MechatronixLab/WPM/README.md

# WEARABLE PATIENT MONITOR  
  
This work is a proof of concept for a connected wearable patient monitor capable of measuring oximetry parameters, 
body temperature and track the patient's movement, while transmitting data wirelessly via LoRa communication.  
  
It is based on the [**Nucleo WL55JC1**](https://www.st.com/en/evaluation-tools/nucleo-wl55jc.html) development board, 
based on the [STM32WL55JC](https://www.st.com/en/microcontrollers-microprocessors/stm32wl55jc.html), from ST Microelectronics, 
a Maxim (now Analog Devices) [**MAX30102**](https://www.analog.com/en/products/max30102.html) pulse oximetry sensor, 
a Würth Elektronik [**WSEN-ISDS**](https://www.we-online.com/en/components/products/WSEN-ISDS) 6-Axis IMU, 
an **OLED display** and a **Piezoelectric buzzer** for simple audio generation.  
  
The device features LoRa connection, allowing it to be used in remote locations where telecommunications infrastructure is not well established.
  
## ⚠️ DISCLAIMER ⚠️  

**THIS IS NOT A MEDICAL DEVICE!**  
  
Putting a medical device on the market is no joke! It involves severe testing, documentation and certification.  
  
The device presented here is a benchtop prototype developed for learning purposes only. 
This prototype was not designed or tested for electrical safety and electromagnetic compatibility, nor went through clinical trials.  
  
**DO NOT TAKE MEDICAL DECISIONS BASED ON MEASUREMENTS TAKEN BY THIS DEVICE!**  
  
## VIDEO DEMONSTRATION

Video Demonstration (https://www.youtube.com/watch?v=pYWwEWDq1WM)  
  
## MOTIVATION

Many patients in need of medical assistance could be treated more comfortably at home, but monitoring their condition in a timely manner could be a challenge, especially if they live in rural areas.  
  
The goal of this project is to develop a low power, wirelessly connected, wearable device to monitor patient heart rate, oximetry, respiration rate, temperature and estimate overall condition. The device would include a microcontroller that manages sensors (such as optical, thermal, inertial, etc.) and connects to an IoT network such as LoRaWAN. A rechargeable battery would also be present, as well as the corresponding power management IC.  
  
The NUCLEO-WL55JC would be a great platform for prototyping such device, since it provides the sub-GHz radio and full access to the MCU pins. Sensors and other hardware parts can be integrated using I2C and SPI communication, and are generally available in breakout boards for easy development.  
  
This kind of device enables caregivers and physicians to monitor their patients remotely and gather information continuously. The data collected can also be processed autonomously using AI to detect potential degradation of patient’s condition and triggering alarms, while simpler analysis could be done directly by the IoT device (edge computing).  
  
The benefits of the device go beyond patient’s health. The overall treatment cost could be lowered since caregivers and physicians could focus attention on the most critical patients more often, and more stable patients can be visited more sporadically.  

This idea was submitted to the [STM32 Wireless Innovation Design Contest](https://www.elektormagazine.com/st-contest), promoted by [Elektor Magazine](https://www.elektormagazine.com/) and [ST Microelectronics](https://github.com/stmicroelectronics). They kindly provided a NUCLEO-WL55JC board, free of charge. Thank you!
  
## HARDWARE

### Hardware Block Diagram

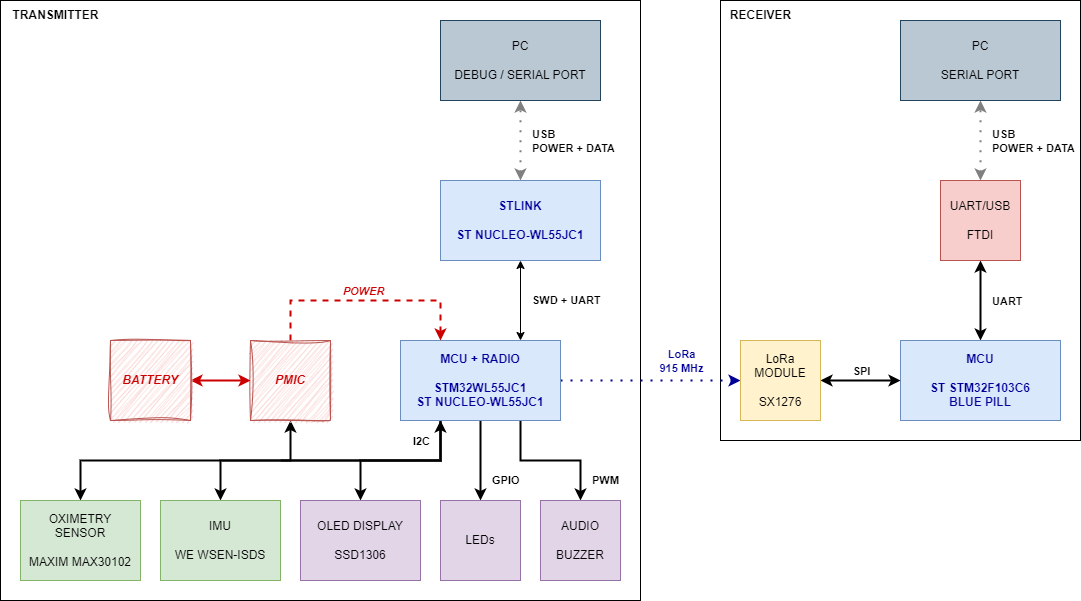
[picture p1: DOC/WPM-WL55_HARDWARE_BLOCK_DIAGRAM.png]
Hardware Block Diagram

  
### Benchtop Prototype  
  
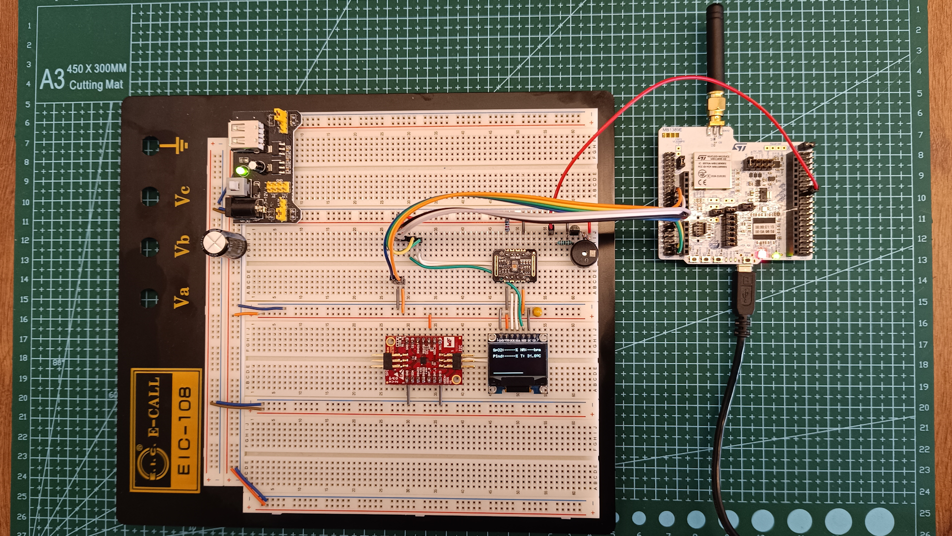
[picture p2: IMG/prototype.png]
Prototype


The image below highlights the main parts of the hardware (from right to left):  
- Nucleo board
- Piezoelectric buzzer
- MAX30102 breakout board
- OLED display (monochrome, 128 x 64 pixels)
- [WSEN-EVAL ISDS](https://www.we-online.com/en/components/products/WSEN-EVAL_ISDS) breakout board
- Voltage regulators (+5.0V and +3.3V)

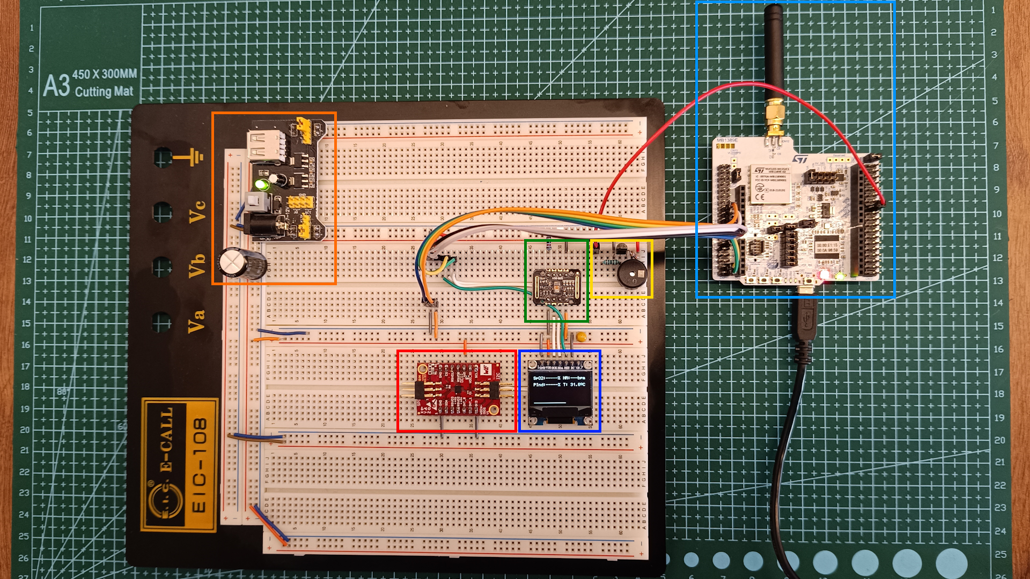
[picture p3: IMG/prototype_highlighted.png]
Prototype - Parts highlighted


The sensors and display are all controlled by the MCU via the same I2C bus. The buzzer is driven by a PWM signal with tone frequency of 4 kHz.
  
**Connections (CubeMX):**    
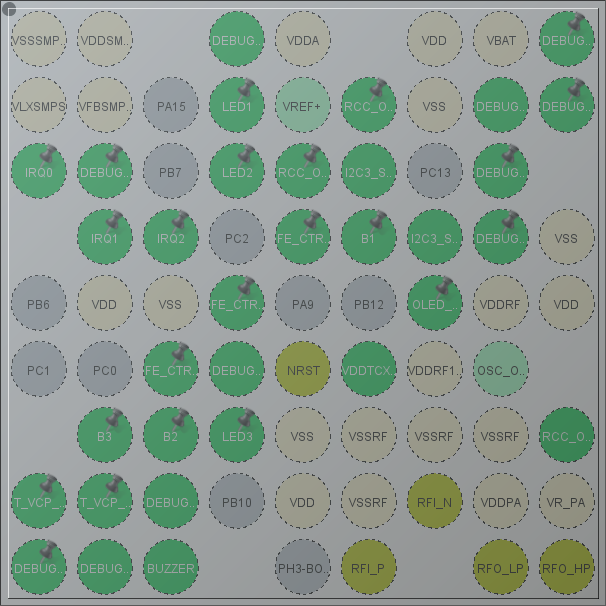
[picture p4: IMG/cubemx_pinout_detail.png]
Hardware connections


Pinout table for connection between the Nucleo board 
([Nucleo WL55JC1 schematic](https://www.st.com/resource/en/schematic_pack/mb1389-wl55jc-highband-e02_schematic.pdf)) 
and other components on the breadboard:

| **Nucleo WL55JC1** | **MCU Pin** | **Peripheral** | **Signal** |
|:---:|:---:|:---:|:---:|
| CN7 Pin 16 | VDD | - | +3.3V |
| CN7 Pin 18 | - | - | +5.0V |
| CN7 Pin 20 | VSS | - | GND |
| CN7 Pin 22 | VSS | - | GND |
| CN7 Pin 28 | PB1 | GPIO | OLED_RESET |
| CN7 Pin 36 | PB14 | I2C3 SDA | I2C SDA |
| CN7 Pin 38 | PB13 | I2C3 SCL | I2C SCL |
| CN10 Pin 16 | PA8 | TIM1 CH1 PWM Out | BUZZER |
  
### LoRa Receiver  
  
A very simple LoRa receiver was assembled using a [LoRa module](https://www.nicerf.com/lora-module/sx1276-lora-module-lora1276.html) from [G-NiceRF](https://www.nicerf.com/), 
which is based on the [SX1276](https://www.semtech.com/products/wireless-rf/lora-connect/sx1276) chip from [Semtech](https://www.semtech.com/), and a Blue Pill board, which is based on the ST Microelectronics [STM32F103C6](https://www.st.com/en/microcontrollers-microprocessors/stm32f103c6.html).    
The software running on the BluePill is a slightly modified version of [arduino-LoRa-STM32](https://github.com/armtronix/arduino-LoRa-STM32) that was developed by [ARMtronix Technologies](https://github.com/armtronix).
  
**LoRa module:**  
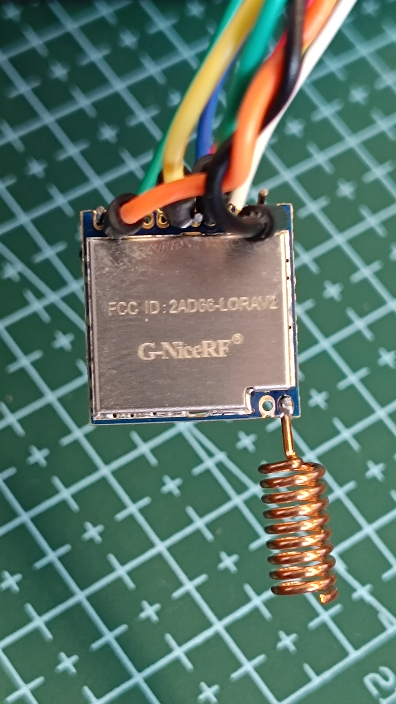
[picture p5: IMG/sx1276_module.png]

  
More information about how to make this receiver can be found on this [video](https://www.youtube.com/watch?v=A0RhP0SkhkQ&ab_channel=HowToElectronics) 
and [arcticle](https://how2electronics.com/interfacing-lora-sx1276-with-stm32-microcontroller-lr1276-915mhz/) from [How To Electronics](https://how2electronics.com/).
  
**Receiver:**    
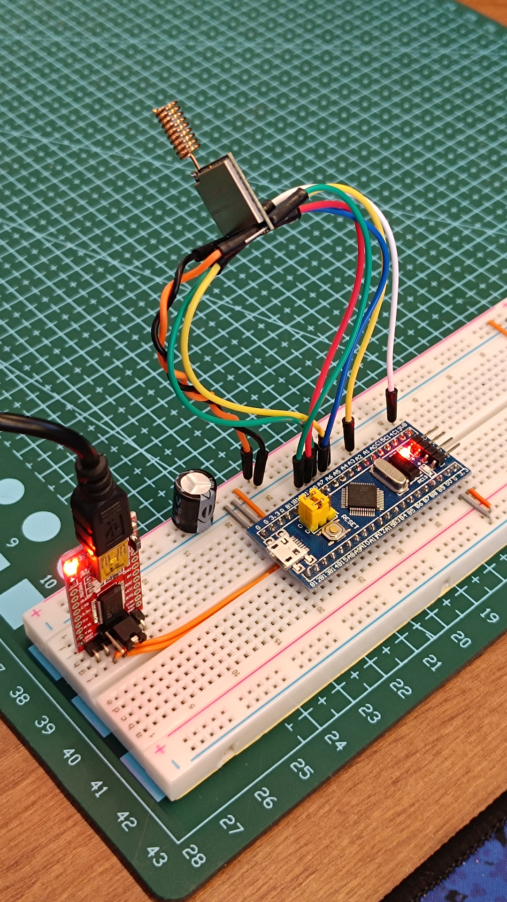
[picture p6: IMG/lora_receiver.png]

  
The software modifications made were necessary to match the radio configurations on the STM32WL55:  
- Frequency: 915 MHz  
- Bandwidth: 500 kHz  
- Spreading Factor: 11  
  
Pinout connections for LoRa receiver (white cable of previous image is not connected):  
  
| **BLUE PILL (STM32F103C6)** | **SX1276 MODULE** | **FTDI MODULE** |
|:---:|:---:|:---:|
| GND | GND | GND |
| +3.3V | VCC | VCC |
| PA4 | NSS | - |
| PA1 | DIO0 | - |
| PA5 | SCK | - |
| PA6 | MISO | - |
| PA7 | MOSI | - |
| PA9 | - | RX |
| PA10 | - | TX |
| PB0 | RST | - |
  
## SOFTWARE  

### Software Block Diagram

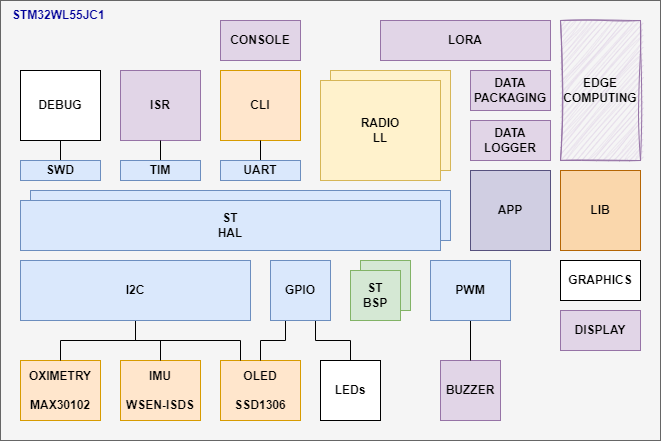
[picture p7: DOC/WPM-WL55_SOFTWARE_BLOCK_DIAGRAM.png]
Hardware Block Diagram

  
### Initialization
  
As the software starts, 3 opening screens are shown:  
  
**Project Title:**  
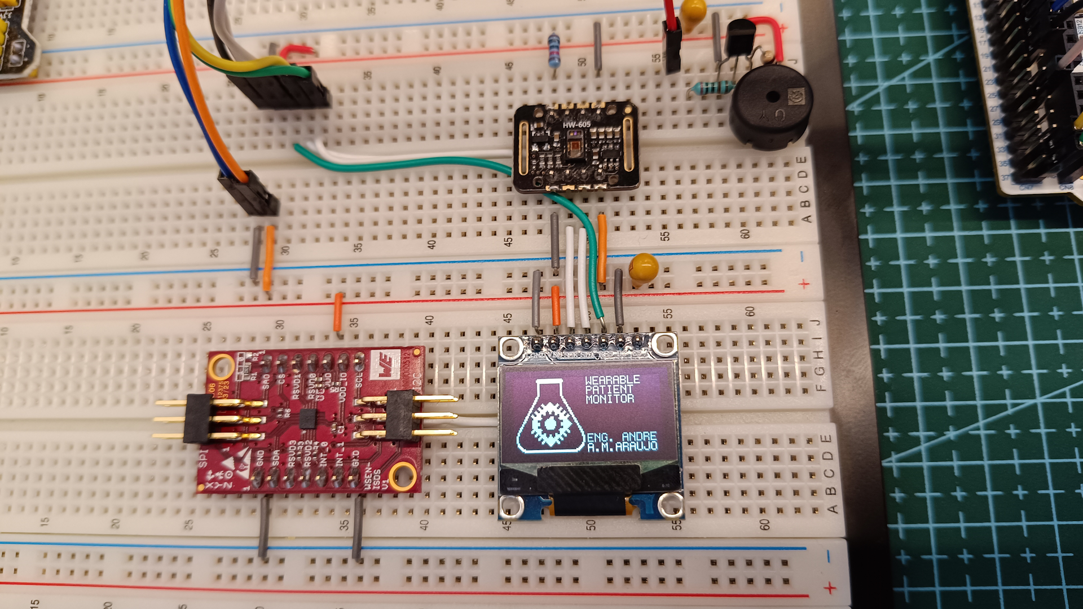
[picture p8: IMG/screen_opening_1.png]
Opening screen 1 - Project Title
  
  
**Software Version:**    
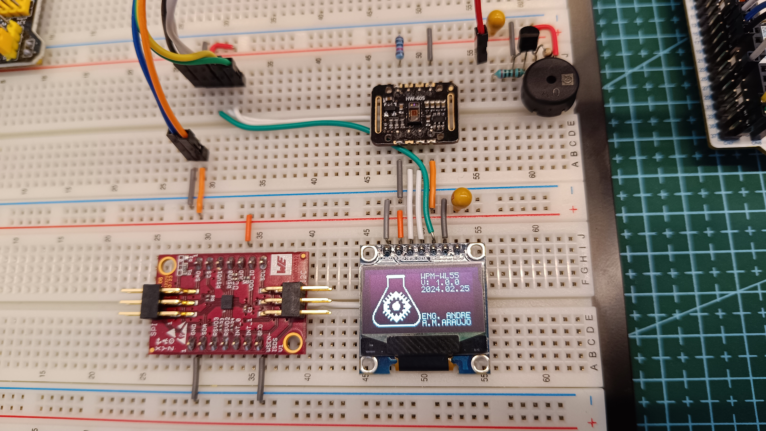
[picture p9: IMG/screen_opening_2.png]
Opening screen 2 - Software Version
  
  
**Elektor/ST Contest information:**  
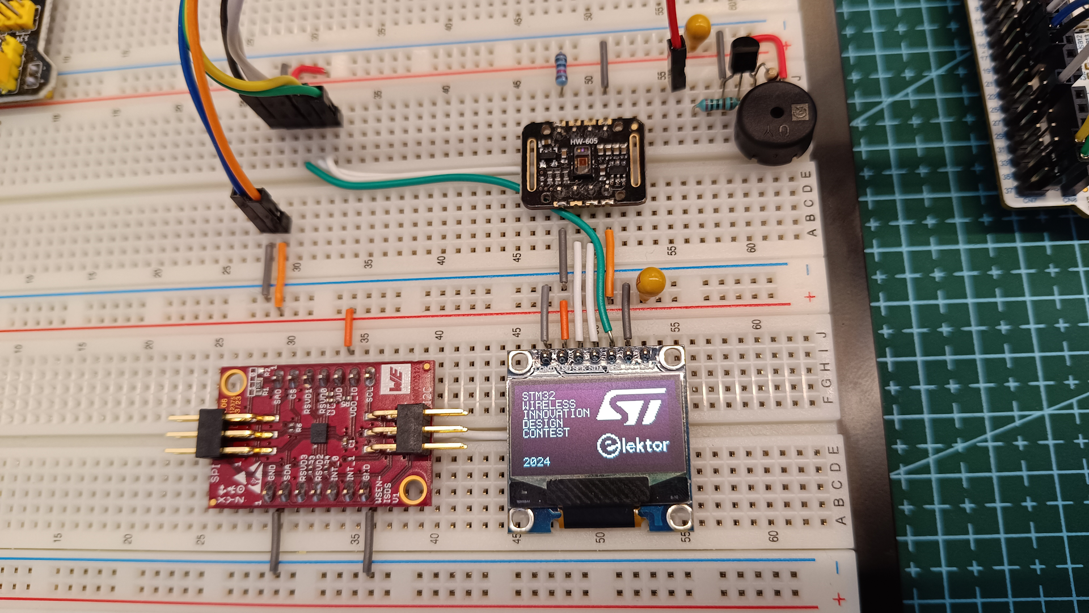
[picture p10: IMG/screen_opening_3.png]
Opening screen 3 - Elektor/ST Contest information
  
  
The device also prints data via its serial port. After initialization information, the device continuously transmits raw data from sensors at a rate of 30 Hz.
This transmission can only be done while the USB cable is connected to the Nucleo board, so it is available mainly for development and debugging purposes.  
  
Data is sent via LoRa at a rate of 1 Hz.    
  
**Console:**  
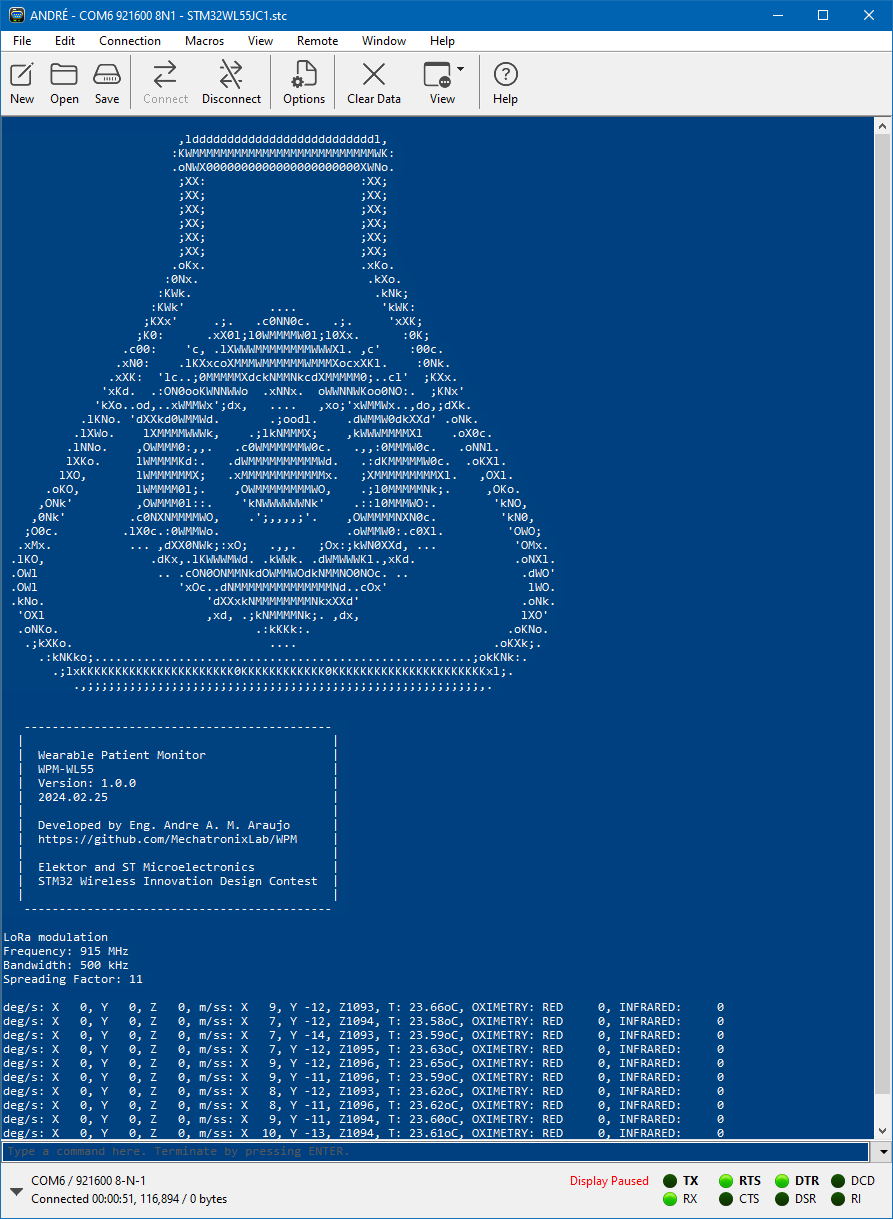
[picture p11: IMG/serial_console.png]
Serial console
    
  
### Measurements
  
The patient should place their finger over the MAX30102 sensor to get oximetry measurements.

The following parameters are present:
- **SpO2**: Peripheral Saturation of Oxygen (%)
- **PInd**: Perfusion Index (%)
- **HR**: Heart rate (beats per minute)
- **T**: Finger temperature (°C)
  
**Working oximetry measurements:**  
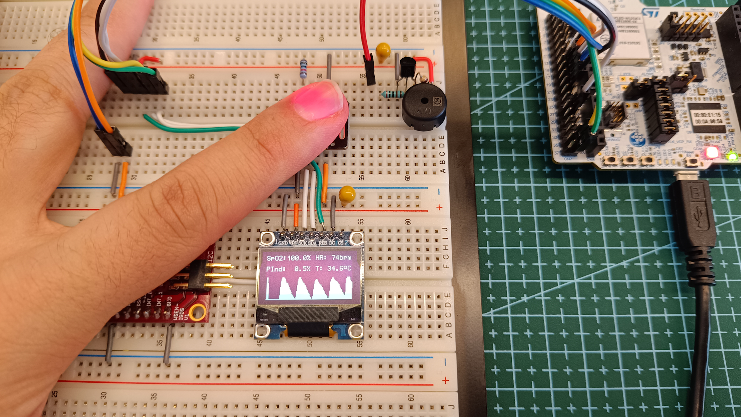
[picture p12: IMG/spo2_working.png]
Working oximetry measurements
  

Using the [Serial Oscilloscope](https://x-io.co.uk/serial-oscilloscope/) tool from [x-io Technologies](https://x-io.co.uk/), it is possible to plot the raw data transmitted from the prototype in real time:
  
**Gyroscope raw data:**  
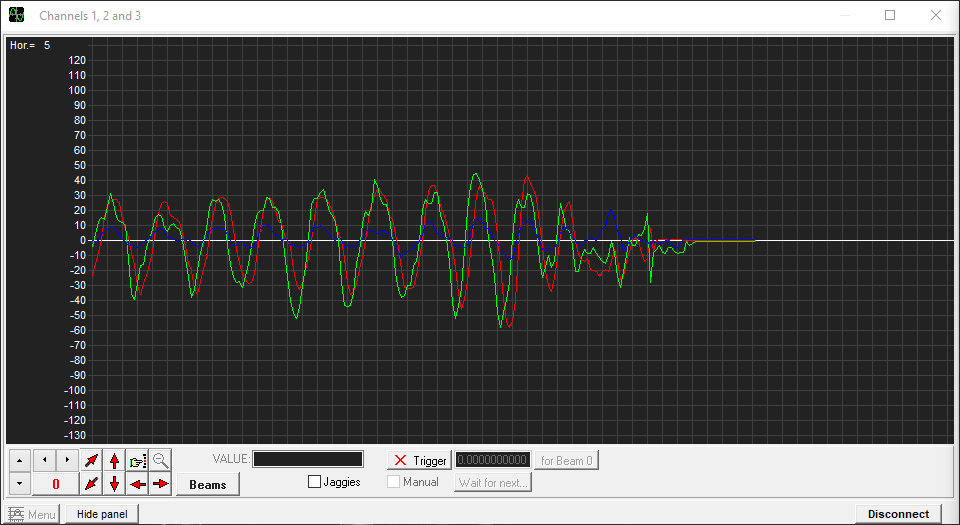
[picture p13: IMG/serial_oscilloscope_gyro.png]
Serial Oscilloscope - Gyroscope raw data
  
  
**Accelerometer raw data:**  
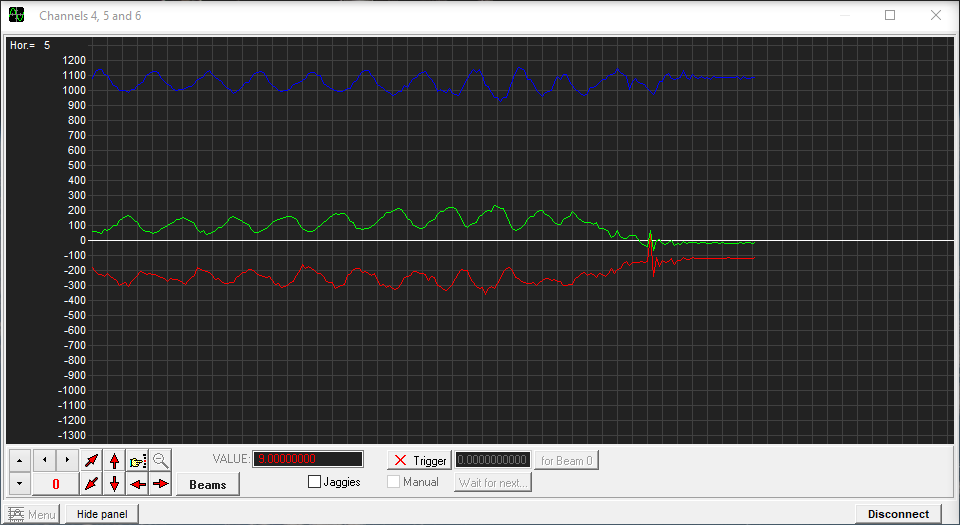
[picture p14: IMG/serial_oscilloscope_accel.png]
Serial Oscilloscope - Accelerometer raw data
  

**Oximetry raw data:**  
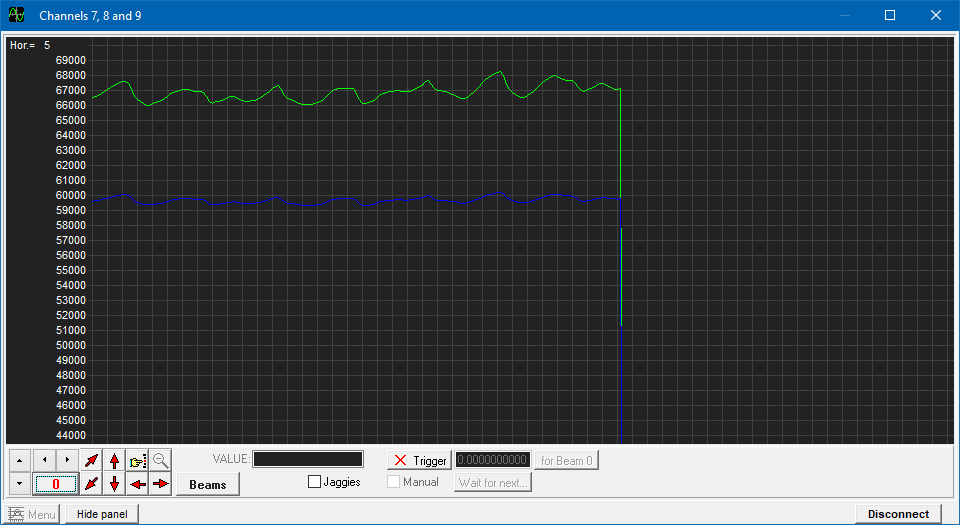
[picture p15: IMG/serial_oscilloscope_oxim.png]
Serial Oscilloscope - Oximetry raw data
  
  
### LoRa Receiver
  
The receiver simply relays data from the LoRa module to the UART, which is then converted to USB and captured by a computer.  
  
**Data received via LoRa:**  
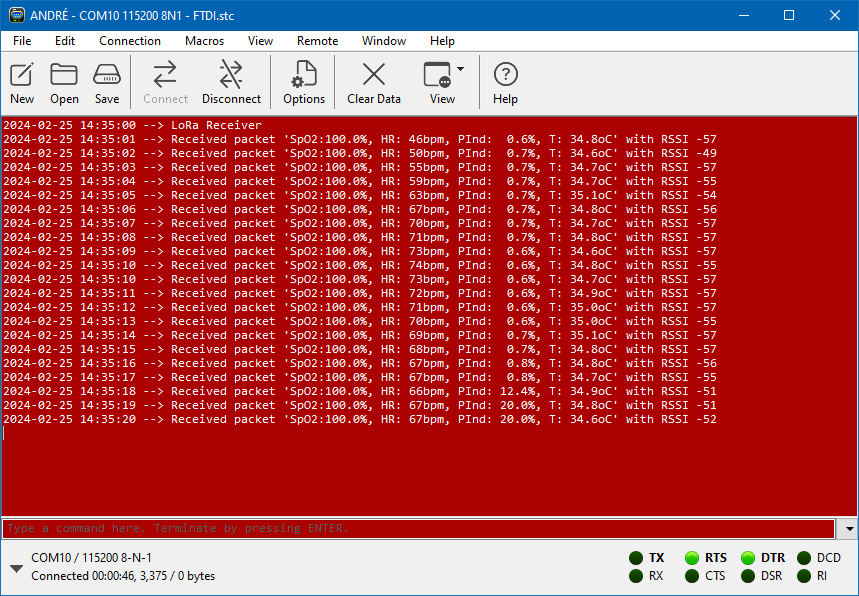
[picture p16: IMG/lora_receiver_serial.png]
Data received via LoRa
  

### Code organization
  
Code is organized according to the following layered architecture diagram.

**Layered architecture software diagram:**
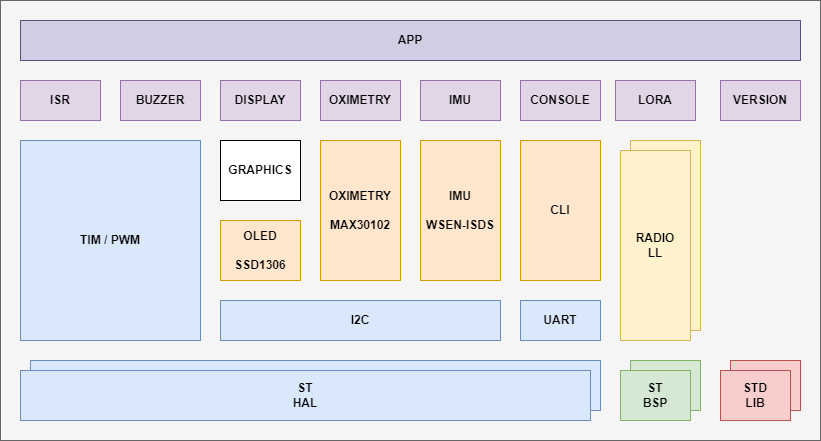
[picture p17: DOC/WPM-WL55_LAYERED_DIAGRAM.png]
  

The idea is that each block in the diagram corresponds to a pair of .c/.h files that are loosely coupled, so the interfaces of libraries occur only in the vertical direction, and only one layer at a time. 
However, since the code is still in development, there are a few exceptions to this guideline throughout the code. Data is manipulated between layers using structures and pointers.  

### Sub-GHz module
  
The most complex part of the project was to get the Sub-GHz module working correctly. 
Most of the examples available on the CubeMX package rely on a scheduler that uses function pointers and is not trivial to understand. 
Additionally, most examples demand two Nucleo boards, and this project had only one available. 
Therefore, a simpler approach was used by configuring the Sub-GHz module using the Low Lever drivers.
[This arcticle](https://forum.digikey.com/t/using-the-low-level-sub-ghz-radio-driver-for-the-stm32wl-series/18253) 
detais the procedure on how to set the radio correctly, and was used as base for starting software development. All other modules were added upon this foundation.  
  
## SIGNAL PROCESSING
  
One of the most interesting part of this project was dealing with the raw data coming from the red and infrared LEDs present on the oximetry sensor.  

In order to obtain the peripheral oxygen saturation value, the algorithm detailed on [this application note from Maxim](https://pdfserv.maximintegrated.com/en/an/AN6409.pdf).  
Another great resource about this topic is [this one from Texas Instruments](https://www.ti.com/lit/an/slaa655/slaa655.pdf).  

The basic idea is to get the DC and AC component from both red and infrared signals, then obtain the "Ratio of Ratios" and use it in a linear regression to finally get an approximate SpO2 value. 
This obviously leads to deviations from the real oxygen saturation of the patient, but this simplification is reasonable for this POC.  

**Raw signal with DC and AC components; Linear regression using the Ratio of Ratios:**
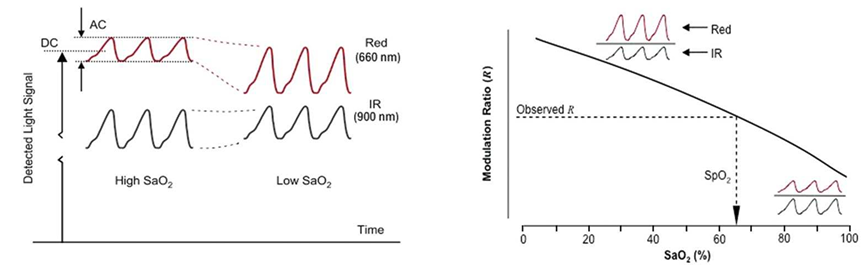
[picture p18: DOC/signal_processing.png]
  

A series of circular buffers were used to calculate the moving average of the two signals, to get DC values and the RMS calculation was used to obtain the AC values.

To get the heart rate, the derivative of the red signal in respect to time is used, and since the negative parts of the derivative are more abrupt, they were used to signal a heartbeat detection.
Again, circular buffer were used to get moving averages of beats for a number of samples, and then the heart rate in beats per minute is calculated.  
  
## PROTOTYPE PERFORMANCE
  
In order to evaluate the performance of the oximetry, 
measurements were taken by the WPM prototype and a commercially available pulse oximeter, simultaneously. 
Results showed good coherence between the two devices.
  
**Comparison between WPM and a commercial pulse oximeter:**  
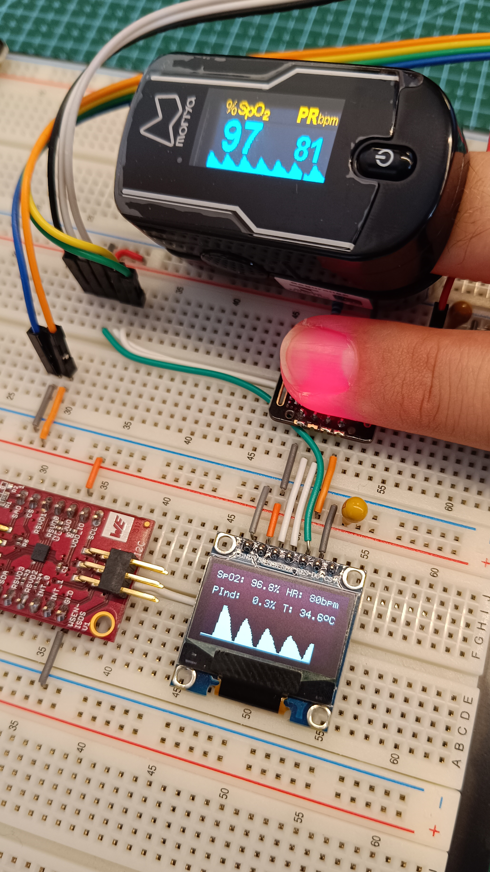
[picture p19: IMG/spo2_comparison.png]

  
## ACKNOWLEDGEMENTS    
  
My lovely wife and kids, for their everlasting support ❤️  
**Karine Moriya** and everyone @ [J.G. Moriya](https://jgmoriya.com.br/)  
[**Elecia White**](https://github.com/eleciawhite) and everyone @ [Classpert](https://lms.classpert.com/)  
[**Fabio Souza**](https://github.com/FBSeletronica) and [**Halysson Jr**](https://github.com/halyssonjr) @ [Franzininho](https://github.com/Franzininho)  
**William Maia** and **Daniel Botelho** @ [ST Microelectronics](https://github.com/stmicroelectronics) Brazil  
**Fabio Costa** and **Érico Hassegawa** @ [Würth Elektronik](https://github.com/WurthElektronik) Brazil  
**Maristone Gomes**, **Gabriel de Benevides** and **Fernando Júdice** @ [Salvus](https://www.salvus.me/)  
**Matt Mielke** @ DigiKey, for writing [this arcticle](https://forum.digikey.com/t/using-the-low-level-sub-ghz-radio-driver-for-the-stm32wl-series/18253) explaining how to use the Sub-GHz module on the STM32WL55  
[**Elektor Magazine**](https://www.elektormagazine.com/) and [**ST Microelectronics**](https://github.com/stmicroelectronics), for promoting the [STM32 Wireless Innovation Design Contest](https://www.elektormagazine.com/st-contest)
