MechatronixLab/WPM/DOC/ELEKTOR LABS PROJECT IMAGES/project_image_elektor_labs.jpg

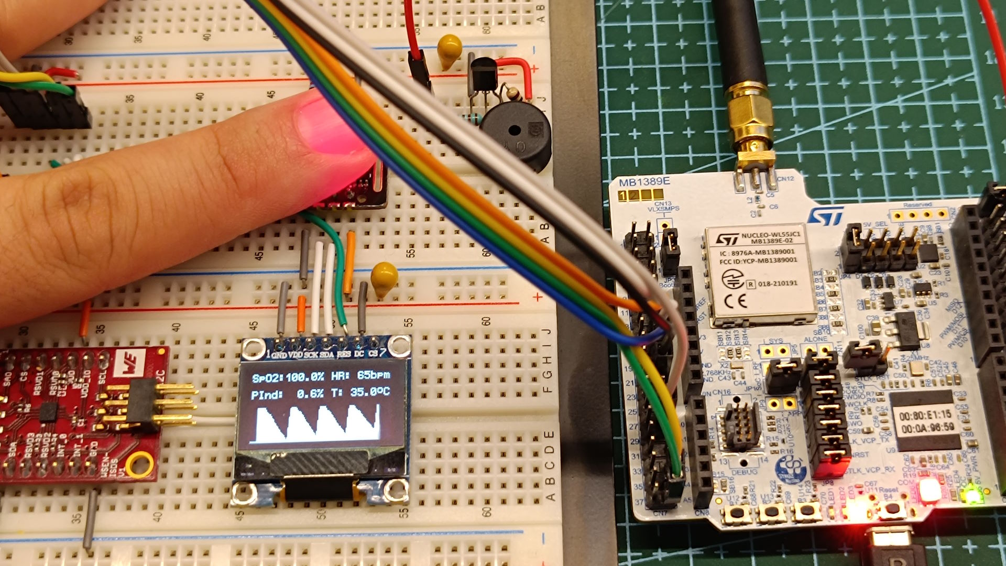
DOC/ELEKTOR LABS PROJECT IMAGES/project_image_elektor_labs.jpg
