MechatronixLab/WPM/IMG/cubemx_pinout.png

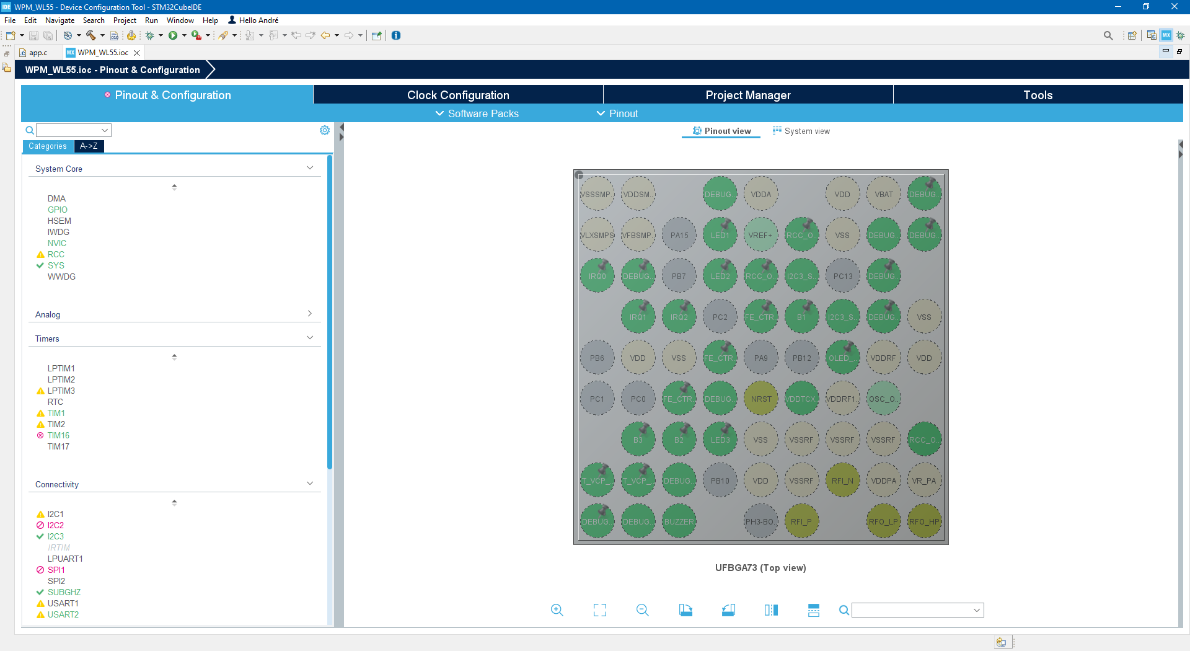
IMG/cubemx_pinout.png
