MechatronixLab/WPM/IMG/serial_oscilloscope.png

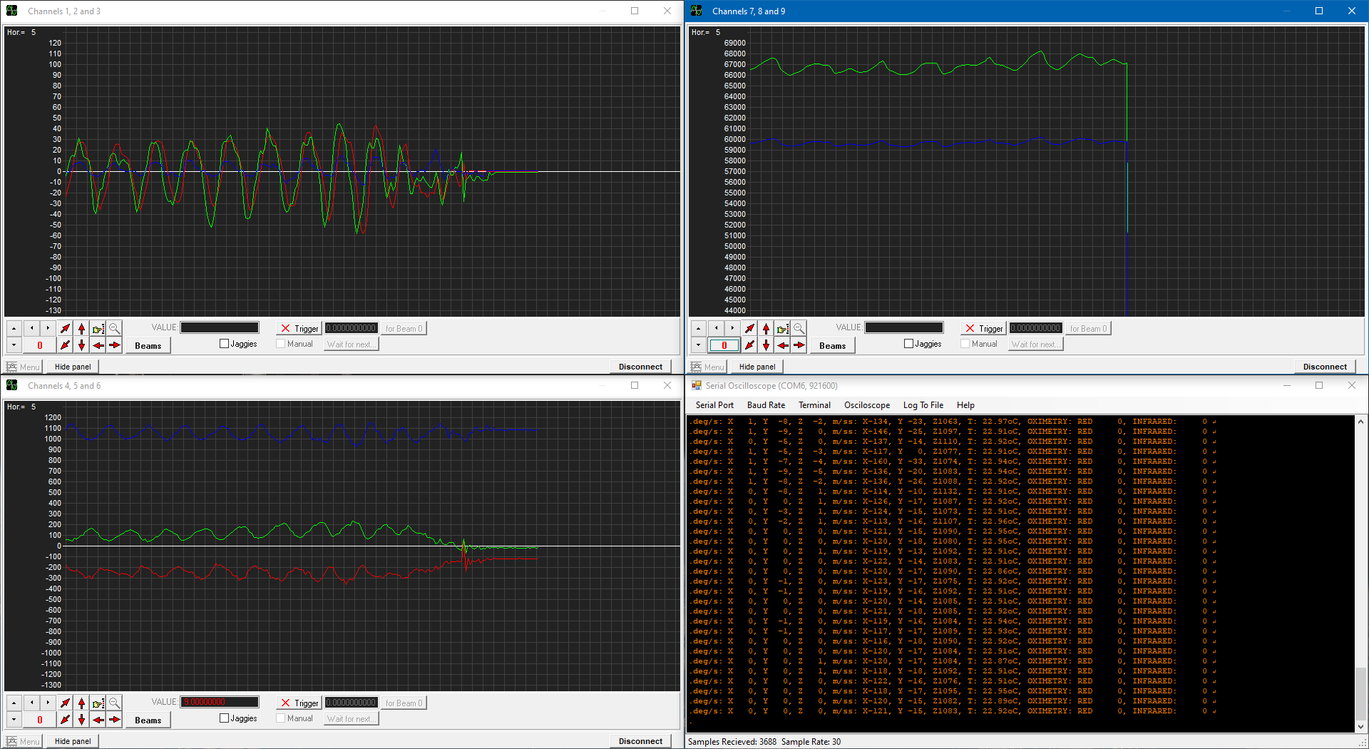
IMG/serial_oscilloscope.png
