MechatronixLab/WPM/IMG/serial_oscilloscope_raw.png

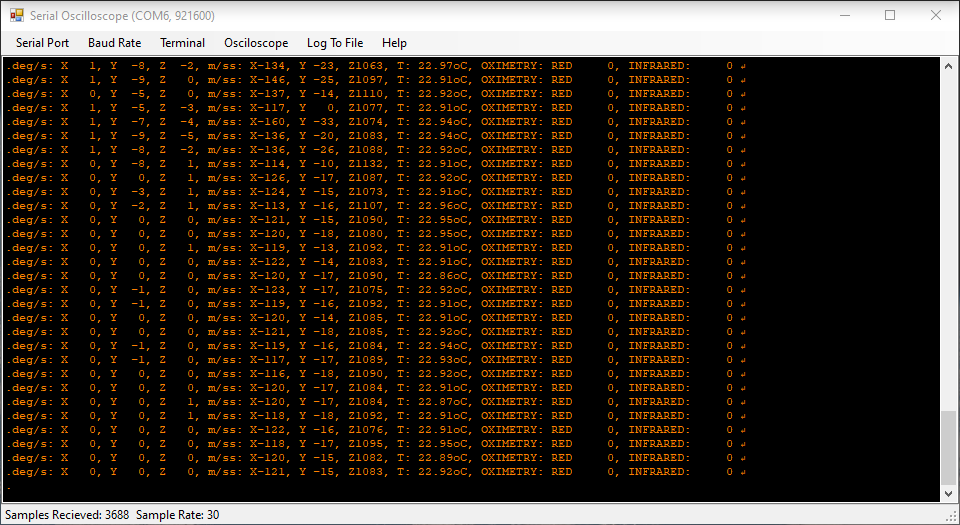
IMG/serial_oscilloscope_raw.png
