MechatronixLab/WPM/IMG/tim16_warning.png

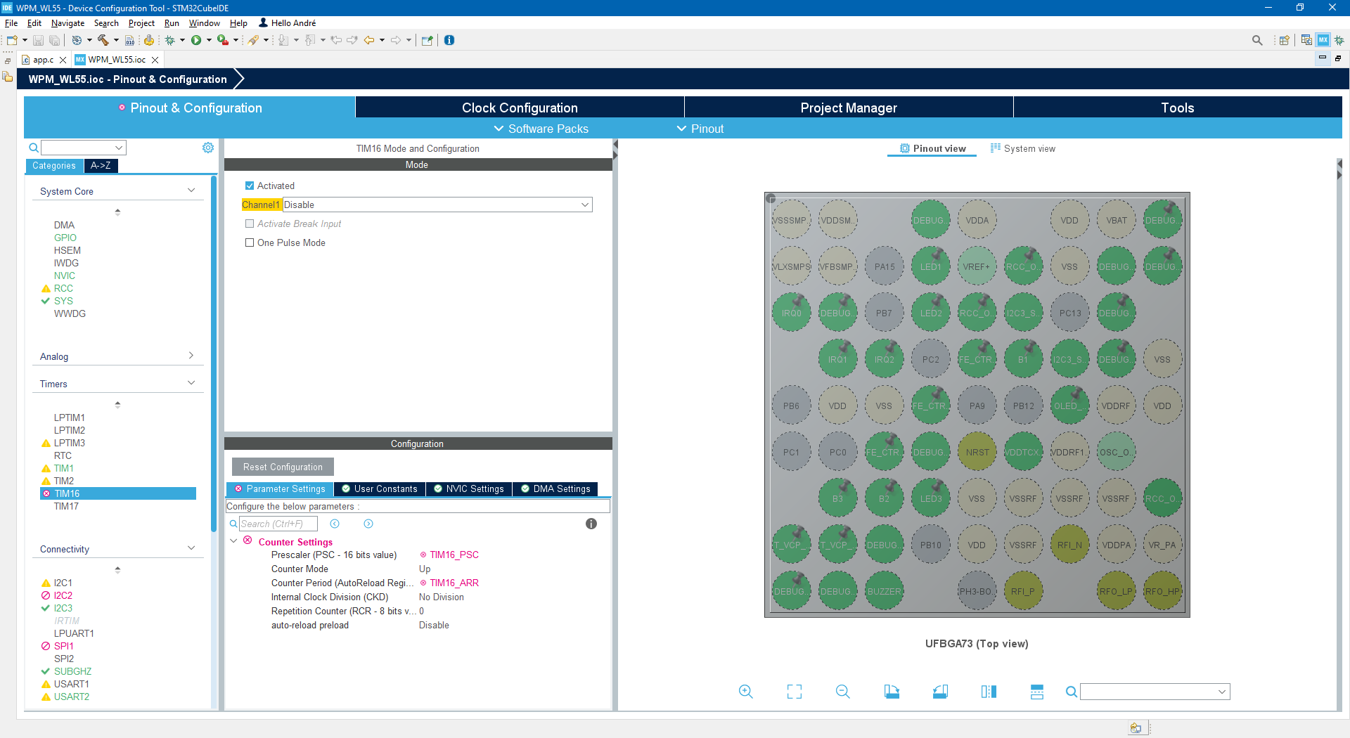
IMG/tim16_warning.png
