MechatronixLab/WPM/SOFTWARE/WPM_WL55/WPM_WL55/WPM_WL55.ioc

Mcu.UserName=STM32WL55JCIx
PA0.GPIO_Label=B1
PA0.Signal=GPXTI0
PA1.GPIO_Label=B2
PA1.Signal=GPXTI1
PA10.Signal=DEBUG_RF-HSE32RDY
PA11.Signal=DEBUG_RF-NRESET
PA12.Signal=DEBUG_RF-BUSY
PA13.Signal=DEBUG_JTMS-SWDIO
PA14.Signal=DEBUG_JTCK-SWCLK
PA2.GPIO_Label=T_VCP_RX
PA2.Signal=USART2_TX
PA3.GPIO_Label=T_VCP_RX
PA3.Signal=USART2_RX
PA4.Signal=DEBUG_SUBGHZSPI-NSSOUT
PA5.Signal=DEBUG_SUBGHZSPI-SCKOUT
PA6.Signal=DEBUG_SUBGHZSPI-MISOOUT
PA7.Signal=DEBUG_SUBGHZSPI-MOSIOUT
PA8.GPIO_Label=BUZZER
PA8.Signal=S_TIM1_CH1
PB0-VDD_TCXO.Signal=VDDTCXO
PB1.GPIO_Label=OLED_RESET
PB1.Signal=GPIO_Output
PB11.GPIO_Label=LED3
PB11.Signal=GPIO_Output
PB13.Signal=I2C3_SCL
PB14.Signal=I2C3_SDA
PB15.GPIO_Label=LED1
PB15.Signal=GPIO_Output
PB2.Signal=DEBUG_RF-SMPSRDY
PB3.GPIO_Label=IRQ0
PB3.Signal=EVENTOUT
PB4.Signal=DEBUG_RF-LDORDY
PB5.GPIO_Label=IRQ1
PB5.Signal=EVENTOUT
PB8.GPIO_Label=IRQ2
PB8.Signal=EVENTOUT
PB9.GPIO_Label=LED2
PB9.Signal=GPIO_Output
PC14-OSC32_IN.Signal=RCC_OSC32_IN
PC15-OSC32_OUT.Signal=RCC_OSC32_OUT
PC3.GPIO_Label=FE_CTRL3
PC3.Signal=GPIO_Output
PC4.GPIO_Label=FE_CTRL1
PC4.Signal=GPIO_Output
PC5.GPIO_Label=FE_CTRL2
PC5.Signal=GPIO_Output
PC6.GPIO_Label=B3
PC6.Signal=GPXTI6
