MechatronixLab/WPM/SOFTWARE/WPM_WL55/WPM_WL55/Core/Inc/main.h

#define LED1_Pin GPIO_PIN_15
#define LED1_GPIO_Port GPIOB
#define IRQ0_Pin GPIO_PIN_3
#define IRQ0_GPIO_Port GPIOB
#define LED2_Pin GPIO_PIN_9
#define LED2_GPIO_Port GPIOB
#define IRQ1_Pin GPIO_PIN_5
#define IRQ1_GPIO_Port GPIOB
#define IRQ2_Pin GPIO_PIN_8
#define IRQ2_GPIO_Port GPIOB
#define FE_CTRL3_Pin GPIO_PIN_3
#define FE_CTRL3_GPIO_Port GPIOC
#define B1_Pin GPIO_PIN_0
#define B1_GPIO_Port GPIOA
#define B1_EXTI_IRQn EXTI0_IRQn
#define FE_CTRL2_Pin GPIO_PIN_5
#define FE_CTRL2_GPIO_Port GPIOC
#define OLED_RESET_Pin GPIO_PIN_1
#define OLED_RESET_GPIO_Port GPIOB
#define FE_CTRL1_Pin GPIO_PIN_4
#define FE_CTRL1_GPIO_Port GPIOC
#define B3_Pin GPIO_PIN_6
#define B3_GPIO_Port GPIOC
#define B3_EXTI_IRQn EXTI9_5_IRQn
#define B2_Pin GPIO_PIN_1
#define B2_GPIO_Port GPIOA
#define B2_EXTI_IRQn EXTI1_IRQn
#define LED3_Pin GPIO_PIN_11
#define LED3_GPIO_Port GPIOB
#define T_VCP_RX_Pin GPIO_PIN_3
#define T_VCP_RX_GPIO_Port GPIOA
#define T_VCP_RXA2_Pin GPIO_PIN_2
#define T_VCP_RXA2_GPIO_Port GPIOA
#define BUZZER_Pin GPIO_PIN_8
#define BUZZER_GPIO_Port GPIOA
