MechatronixLab/WPM/SOFTWARE/WPM_WL55/WPM_WL55/App/Src/lora.c

/*
 * lora.c
 *
 *  Created on: Feb 1, 2024
 *      Author: Eng. André A. M. Araújo
 */

// References:
// https://forum.digikey.com/t/using-the-low-level-sub-ghz-radio-driver-for-the-stm32wl-series/18253
// https://github.com/eewiki/stm32wl_radioDriver_pingPong/tree/main

#include "lora.h"

void (*volatile eventReceptor)(pingPongFSM_t *const fsm);
PacketParams_t packetParams;  // TODO: this is lazy

static pingPongFSM_t fsm;
static char uartBuff[100];

const RadioLoRaBandwidths_t Bandwidths[] = { LORA_BW_125, LORA_BW_250, LORA_BW_500 };

/**
  * @brief  Initialize the Sub-GHz radio and dependent hardware.
  * @retval None
  */
void LORA_RadioInit(void)
{
	char string_buffer[64];

	CLI_Write("LoRa modulation \r\n");
	sprintf(string_buffer, "Frequency: %d MHz \r\n", LORA_RF_FREQUENCY/1000000);
	CLI_Write(string_buffer);
	sprintf(string_buffer, "Bandwidth: %d kHz \r\n", (1 << LORA_BANDWIDTH) * 125);
	CLI_Write(string_buffer);
	sprintf(string_buffer, "Spreading Factor: %d \r\n", LORA_SPREADING_FACTOR);
	CLI_Write(string_buffer);
	CLI_NewLine();

	// Initialize the hardware (SPI bus, TCXO control, RF switch)
	SUBGRF_Init(LORA_RadioIRQ);

	// Use DCDC converter if `DCDC_ENABLE` is defined in radio_conf.h
	// "By default, the SMPS clock detection is disabled and must be enabled before enabling the SMPS." (6.1 in RM0453)
	SUBGRF_WriteRegister(SUBGHZ_SMPSC0R, (SUBGRF_ReadRegister(SUBGHZ_SMPSC0R) | SMPS_CLK_DET_ENABLE));
	SUBGRF_SetRegulatorMode();

	// Use the whole 256-byte buffer for both TX and RX
	SUBGRF_SetBufferBaseAddress(0x00, 0x00);

	SUBGRF_SetRfFrequency(LORA_RF_FREQUENCY);
	SUBGRF_SetRfTxPower(LORA_TX_POWER);
	SUBGRF_SetStopRxTimerOnPreambleDetect(false);

	SUBGRF_SetPacketType(PACKET_TYPE_LORA);

	SUBGRF_WriteRegister( REG_LR_SYNCWORD, ( LORA_MAC_PRIVATE_SYNCWORD >> 8 ) & 0xFF );
	SUBGRF_WriteRegister( REG_LR_SYNCWORD + 1, LORA_MAC_PRIVATE_SYNCWORD & 0xFF );

	ModulationParams_t modulationParams;
	modulationParams.PacketType = PACKET_TYPE_LORA;
	modulationParams.Params.LoRa.Bandwidth = Bandwidths[LORA_BANDWIDTH];
	modulationParams.Params.LoRa.CodingRate = (RadioLoRaCodingRates_t)LORA_CODINGRATE;
	modulationParams.Params.LoRa.LowDatarateOptimize = 0x00;
	modulationParams.Params.LoRa.SpreadingFactor = (RadioLoRaSpreadingFactors_t)LORA_SPREADING_FACTOR;
	SUBGRF_SetModulationParams(&modulationParams);

	packetParams.PacketType = PACKET_TYPE_LORA;
	packetParams.Params.LoRa.CrcMode = LORA_CRC_ON;
	packetParams.Params.LoRa.HeaderType = LORA_PACKET_VARIABLE_LENGTH;
	packetParams.Params.LoRa.InvertIQ = LORA_IQ_NORMAL;
	packetParams.Params.LoRa.PayloadLength = 0xFF;
	packetParams.Params.LoRa.PreambleLength = LORA_PREAMBLE_LENGTH;
	SUBGRF_SetPacketParams(&packetParams);

	//SUBGRF_SetLoRaSymbNumTimeout(LORA_SYMBOL_TIMEOUT);

	// WORKAROUND - Optimizing the Inverted IQ Operation, see DS_SX1261-2_V1.2 datasheet chapter 15.4
	// RegIqPolaritySetup @address 0x0736
	SUBGRF_WriteRegister( 0x0736, SUBGRF_ReadRegister( 0x0736 ) | ( 1 << 2 ) );

	LORA_Tx("Wearable Patient Monitor");
	HAL_Delay(300);
	LORA_Tx("WPM-WL55");
	HAL_Delay(300);
	LORA_Tx("Developed by Eng. Andre A. M. Araujo");
	HAL_Delay(300);
}


/**
  * @brief  Receive data trough SUBGHZSPI peripheral
  * @param  radioIrq  interrupt pending status information
  * @retval None
  */
void LORA_RadioIRQ(RadioIrqMasks_t radioIrq)
{
  switch (radioIrq)
  {
    case IRQ_TX_DONE:
      eventReceptor = eventTxDone;
      break;
    case IRQ_RX_DONE:
      eventReceptor = eventRxDone;
      break;
    case IRQ_RX_TX_TIMEOUT:
      if (SUBGRF_GetOperatingMode() == MODE_TX)
      {
        eventReceptor = eventTxTimeout;
      }
      else if (SUBGRF_GetOperatingMode() == MODE_RX)
      {
        eventReceptor = eventRxTimeout;
      }
      break;
    case IRQ_CRC_ERROR:
      eventReceptor = eventRxError;
      break;
    default:
      break;
  }
}


/**
  * @brief  Process the TX Done event
  * @param  fsm pointer to FSM context
  * @retval None
  */
void eventTxDone(pingPongFSM_t *const fsm)
{
  HAL_UART_Transmit(&huart2, (uint8_t *)"Event TX Done\r\n", 15, HAL_MAX_DELAY);
  switch (fsm->state)
  {
    case STATE_MASTER:
      switch (fsm->subState)
      {
        case SSTATE_TX:
          enterMasterRx(fsm);
          fsm->subState = SSTATE_RX;
          break;
        default:
          break;
      }
      break;
    case STATE_SLAVE:
      switch (fsm->subState)
      {
        case SSTATE_TX:
          enterSlaveRx(fsm);
          fsm->subState = SSTATE_RX;
          break;
        default:
          break;
      }
      break;
    default:
      break;
  }
}


/**
  * @brief  Process the RX Done event
  * @param  fsm pointer to FSM context
  * @retval None
  */
void eventRxDone(pingPongFSM_t *const fsm)
{
  HAL_UART_Transmit(&huart2, (uint8_t *)"Event RX Done\r\n", 15, HAL_MAX_DELAY);
  HAL_UART_Transmit(&huart2, (uint8_t *)"RX Buffer: ", 11, HAL_MAX_DELAY);
  HAL_UART_Transmit(&huart2, (uint8_t *)fsm->rxBuffer, strlen((char *)fsm->rxBuffer), HAL_MAX_DELAY);
  HAL_UART_Transmit(&huart2, (uint8_t *)"\r\n", 2, HAL_MAX_DELAY);
  switch(fsm->state)
  {
    case STATE_MASTER:
      switch (fsm->subState)
      {
        case SSTATE_RX:
          transitionRxDone(fsm);
          if (strncmp(fsm->rxBuffer, "PONG", 4) == 0)
          {
            BSP_LED_Off(LED_GREEN);
            BSP_LED_Toggle(LED_RED);
            enterMasterTx(fsm);
            fsm->subState = SSTATE_TX;
          }
          else if (strncmp(fsm->rxBuffer, "PING", 4) == 0)
          {
            enterSlaveRx(fsm);
            fsm->state = STATE_SLAVE;
          }
          else
          {
        	  enterMasterRx(fsm);
          }
          break;
        default:
          break;
      }
      break;
    case STATE_SLAVE:
      switch (fsm->subState)
      {
        case SSTATE_RX:
          transitionRxDone(fsm);
          if (strncmp(fsm->rxBuffer, "PING", 4) == 0)
          {
            BSP_LED_Off(LED_RED);
            BSP_LED_Toggle(LED_GREEN);
            enterSlaveTx(fsm);
            fsm->subState = SSTATE_TX;
          }
          else
          {
            enterMasterRx(fsm);
            fsm->state = STATE_MASTER;
          }
          break;
        default:
          break;
      }
      break;
    default:
      break;
  }
}


/**
  * @brief  Process the TX Timeout event
  * @param  fsm pointer to FSM context
  * @retval None
  */
void eventTxTimeout(pingPongFSM_t *const fsm)
{
  HAL_UART_Transmit(&huart2, (uint8_t *)"Event TX Timeout\r\n", 18, HAL_MAX_DELAY);
  switch (fsm->state)
  {
    case STATE_MASTER:
      switch (fsm->subState)
      {
        case SSTATE_TX:
          enterMasterRx(fsm);
          fsm->subState = SSTATE_RX;
          break;
        default:
          break;
      }
      break;
    case STATE_SLAVE:
      switch (fsm->subState)
      {
        case SSTATE_TX:
          enterSlaveRx(fsm);
          fsm->subState = SSTATE_RX;
          break;
        default:
          break;
      }
      break;
    default:
      break;
  }
}


/**
  * @brief  Process the RX Timeout event
  * @param  fsm pointer to FSM context
  * @retval None
  */
void eventRxTimeout(pingPongFSM_t *const fsm)
{
  HAL_UART_Transmit(&huart2, (uint8_t *)"Event RX Timeout\r\n", 18, HAL_MAX_DELAY);

  BSP_LED_On(LED_RED);
  HAL_Delay(10);
  BSP_LED_Off(LED_RED);


  switch (fsm->state)
  {
    case STATE_MASTER:
      switch (fsm->subState)
      {
        case SSTATE_RX:
          HAL_Delay(fsm->randomDelay);
          enterMasterTx(fsm);
          fsm->subState = SSTATE_TX;
          break;
        default:
          break;
      }
      break;
    case STATE_SLAVE:
      switch (fsm->subState)
      {
        case SSTATE_RX:
          enterSlaveRx(fsm);
          break;
        default:
          break;
      }
      break;
    default:
      break;
  }
}


/**
  * @brief  Process the RX Error event
  * @param  fsm pointer to FSM context
  * @retval None
  */
void eventRxError(pingPongFSM_t *const fsm)
{
  HAL_UART_Transmit(&huart2, (uint8_t *)"Event Rx Error\r\n", 16, HAL_MAX_DELAY);
  switch (fsm->state)
  {
    case STATE_MASTER:
      switch (fsm->subState)
      {
        case SSTATE_RX:
          HAL_Delay(fsm->randomDelay);
          enterMasterTx(fsm);
          fsm->subState = SSTATE_TX;
          break;
        default:
          break;
      }
      break;
    case STATE_SLAVE:
      switch (fsm->subState)
      {
        case SSTATE_RX:
          enterSlaveRx(fsm);
          break;
        default:
          break;
      }
      break;
    default:
      break;
  }
}


/**
  * @brief  Entry actions for the RX sub-state of the Master state
  * @param  fsm pointer to FSM context
  * @retval None
  */
void enterMasterRx(pingPongFSM_t *const fsm)
{
  HAL_UART_Transmit(&huart2, (uint8_t *)"Master Rx start\r\n", 17, HAL_MAX_DELAY);
  SUBGRF_SetDioIrqParams( IRQ_RX_DONE | IRQ_RX_TX_TIMEOUT | IRQ_CRC_ERROR | IRQ_HEADER_ERROR,
                          IRQ_RX_DONE | IRQ_RX_TX_TIMEOUT | IRQ_CRC_ERROR | IRQ_HEADER_ERROR,
                          IRQ_RADIO_NONE,
                          IRQ_RADIO_NONE );
  SUBGRF_SetSwitch(RFO_LP, RFSWITCH_RX);
  packetParams.Params.LoRa.PayloadLength = 0xFF;
  SUBGRF_SetPacketParams(&packetParams);
  SUBGRF_SetRx(fsm->rxTimeout << 6);
}


/**
  * @brief  Entry actions for the RX sub-state of the Slave state
  * @param  fsm pointer to FSM context
  * @retval None
  */
void enterSlaveRx(pingPongFSM_t *const fsm)
{
  HAL_UART_Transmit(&huart2, (uint8_t *)"Slave Rx start\r\n", 16, HAL_MAX_DELAY);
  SUBGRF_SetDioIrqParams( IRQ_RX_DONE | IRQ_RX_TX_TIMEOUT | IRQ_CRC_ERROR | IRQ_HEADER_ERROR,
                          IRQ_RX_DONE | IRQ_RX_TX_TIMEOUT | IRQ_CRC_ERROR | IRQ_HEADER_ERROR,
                          IRQ_RADIO_NONE,
                          IRQ_RADIO_NONE );
  SUBGRF_SetSwitch(RFO_LP, RFSWITCH_RX);
  packetParams.Params.LoRa.PayloadLength = 0xFF;
  SUBGRF_SetPacketParams(&packetParams);
  SUBGRF_SetRx(fsm->rxTimeout << 6);
}


/**
  * @brief  Entry actions for the TX sub-state of the Master state
  * @param  fsm pointer to FSM context
  * @retval None
  */
void enterMasterTx(pingPongFSM_t *const fsm)
{
  HAL_Delay(fsm->rxMargin);

  HAL_UART_Transmit(&huart2, (uint8_t *)"...PING\r\n", 9, HAL_MAX_DELAY);
  HAL_UART_Transmit(&huart2, (uint8_t *)"Master Tx start\r\n", 17, HAL_MAX_DELAY);
  SUBGRF_SetDioIrqParams( IRQ_TX_DONE | IRQ_RX_TX_TIMEOUT,
                          IRQ_TX_DONE | IRQ_RX_TX_TIMEOUT,
                          IRQ_RADIO_NONE,
                          IRQ_RADIO_NONE );
  SUBGRF_SetSwitch(RFO_LP, RFSWITCH_TX);
  // Workaround 5.1 in DS.SX1261-2.W.APP (before each packet transmission)
  SUBGRF_WriteRegister(0x0889, (SUBGRF_ReadRegister(0x0889) | 0x04));
  packetParams.Params.LoRa.PayloadLength = 0x4;
  SUBGRF_SetPacketParams(&packetParams);
  SUBGRF_SendPayload((uint8_t *)"PING", 4, 0);
}


/**
  * @brief  Entry actions for the TX sub-state of the Slave state
  * @param  fsm pointer to FSM context
  * @retval None
  */
void enterSlaveTx(pingPongFSM_t *const fsm)
{
  HAL_Delay(fsm->rxMargin);

  HAL_UART_Transmit(&huart2, (uint8_t *)"...PONG\r\n", 9, HAL_MAX_DELAY);
  HAL_UART_Transmit(&huart2, (uint8_t *)"Slave Tx start\r\n", 16, HAL_MAX_DELAY);
  SUBGRF_SetDioIrqParams( IRQ_TX_DONE | IRQ_RX_TX_TIMEOUT,
                          IRQ_TX_DONE | IRQ_RX_TX_TIMEOUT,
                          IRQ_RADIO_NONE,
                          IRQ_RADIO_NONE );
  SUBGRF_SetSwitch(RFO_LP, RFSWITCH_TX);
  // Workaround 5.1 in DS.SX1261-2.W.APP (before each packet transmission)
  SUBGRF_WriteRegister(0x0889, (SUBGRF_ReadRegister(0x0889) | 0x04));
  packetParams.Params.LoRa.PayloadLength = 0x4;
  SUBGRF_SetPacketParams(&packetParams);
  SUBGRF_SendPayload((uint8_t *)"PONG", 4, 0);
}


/**
  * @brief  Transition actions executed on every RX Done event (helper function)
  * @param  fsm pointer to FSM context
  * @retval None
  */
void transitionRxDone(pingPongFSM_t *const fsm)
{
  PacketStatus_t packetStatus;
  char uartBuff[50];

  // Workaround 15.3 in DS.SX1261-2.W.APP (because following RX w/ timeout sequence)
  SUBGRF_WriteRegister(0x0920, 0x00);
  SUBGRF_WriteRegister(0x0944, (SUBGRF_ReadRegister(0x0944) | 0x02));

  SUBGRF_GetPayload((uint8_t *)fsm->rxBuffer, &fsm->rxSize, 0xFF);
  SUBGRF_GetPacketStatus(&packetStatus);

  sprintf(uartBuff, "RssiValue=%d dBm, SnrValue=%d Hz\r\n", packetStatus.Params.LoRa.RssiPkt, packetStatus.Params.LoRa.SnrPkt);
  HAL_UART_Transmit(&huart2, (uint8_t *)uartBuff, strlen(uartBuff), HAL_MAX_DELAY);
}

void LORA_FSM_Init(void)
{
	// get random number
	uint32_t rnd = 0;
	SUBGRF_SetDioIrqParams(IRQ_RADIO_NONE, IRQ_RADIO_NONE, IRQ_RADIO_NONE, IRQ_RADIO_NONE);
	rnd = SUBGRF_GetRandom();

	fsm.state = STATE_NULL;
	fsm.subState = SSTATE_NULL;
	fsm.rxTimeout = 3000; // 3000 ms
	fsm.rxMargin = 200;   // 200 ms
	fsm.randomDelay = rnd >> 22; // [0, 1023] ms
	sprintf(uartBuff, "rand=%lu\r\n", fsm.randomDelay);
	HAL_UART_Transmit(&huart2, (uint8_t *)uartBuff, strlen(uartBuff), HAL_MAX_DELAY);

	HAL_Delay(fsm.randomDelay);
	SUBGRF_SetDioIrqParams( IRQ_RX_DONE | IRQ_RX_TX_TIMEOUT | IRQ_CRC_ERROR,
						  IRQ_RX_DONE | IRQ_RX_TX_TIMEOUT | IRQ_CRC_ERROR,
						  IRQ_RADIO_NONE,
						  IRQ_RADIO_NONE );
	SUBGRF_SetSwitch(RFO_LP, RFSWITCH_RX);
	SUBGRF_SetRx(fsm.rxTimeout << 6);
	fsm.state = STATE_MASTER;
	fsm.subState = SSTATE_RX;

	LORA_Tx("LoRa config complete!");	// TODO: Works but breaks state machine
}

void LORA_Process(void)
{
	if (eventReceptor != NULL)
	{
		BSP_LED_On(LED_GREEN);

		eventReceptor(&fsm);
		eventReceptor = NULL;

		BSP_LED_Off(LED_GREEN);
	}
}

void LORA_Tx(char * lora_tx_buffer)
{
//	HAL_Delay(fsm->rxMargin);
//	HAL_UART_Transmit(&huart2, (uint8_t *)"...PING\r\n", 9, HAL_MAX_DELAY);
//	HAL_UART_Transmit(&huart2, (uint8_t *)"Master Tx start\r\n", 17, HAL_MAX_DELAY);

//	CLI_Write("Starting LoRa transmission... \r\n");
	SUBGRF_SetDioIrqParams( IRQ_TX_DONE | IRQ_RX_TX_TIMEOUT,
						  IRQ_TX_DONE | IRQ_RX_TX_TIMEOUT,
						  IRQ_RADIO_NONE,
						  IRQ_RADIO_NONE );
	SUBGRF_SetSwitch(RFO_LP, RFSWITCH_TX);
	// Workaround 5.1 in DS.SX1261-2.W.APP (before each packet transmission)
	SUBGRF_WriteRegister(0x0889, (SUBGRF_ReadRegister(0x0889) | 0x04));
	packetParams.Params.LoRa.PayloadLength = strlen(lora_tx_buffer);
	SUBGRF_SetPacketParams(&packetParams);
	SUBGRF_SendPayload((uint8_t *)lora_tx_buffer, packetParams.Params.LoRa.PayloadLength, 0);
//	CLI_Write("LoRa packet transmitted \r\n");
}
