MechatronixLab/WPM/SOFTWARE/WPM_WL55/WPM_WL55/App/Src/wsen-isds.c

/*
 * wsen-isds.c
 *
 *  Created on: Nov 24, 2023
 *      Author: Eng. André A. M. Araújo
 */

#include "wsen-isds.h"

void	ISDS_Read	(uint8_t register_address, uint8_t data_size, uint8_t * I2C_buffer)
{
	I2C_buffer[0] = register_address;

	HAL_I2C_Master_Transmit(&ISDS_I2C_HANDLE, ISDS_DEVICE_ADDRESS, I2C_buffer,         1, ISDS_I2C_TIMEOUT);
	HAL_I2C_Master_Receive (&ISDS_I2C_HANDLE, ISDS_DEVICE_ADDRESS, I2C_buffer, data_size, ISDS_I2C_TIMEOUT);
}

void	ISDS_Write	(uint8_t register_address, uint8_t data)
{
	uint8_t I2C_buffer[2];

	I2C_buffer[0] = register_address;
	I2C_buffer[1] = data;

	HAL_I2C_Master_Transmit(&ISDS_I2C_HANDLE, ISDS_DEVICE_ADDRESS, I2C_buffer,         2, ISDS_I2C_TIMEOUT);
}

uint8_t ISDS_CommunicationCheck(void)
{
	uint8_t I2C_buffer[1];
	uint8_t status = 0;

	ISDS_Read(ISDS_DEVICE_ID, 1, I2C_buffer);

	if (I2C_buffer[0] == 0x6A)
	{
		status = 0;
	}
	else
	{
		status = 0xFF;
	}
	return status;
}

uint8_t	ISDS_SoftReset(void)
{
	ISDS_Write(ISDS_CTRL3_C, 0x01);
	HAL_Delay(1);
	ISDS_Write(ISDS_CTRL3_C, 0x80);
	HAL_Delay(20);

	return ISDS_CommunicationCheck();
}

void	ISDS_Init(void)	// TODO:
{
	uint8_t I2C_buffer[2];

	// Sensor in power down mode
	// Enable high performance mode
	// Select output data rate 208 Hz
	ISDS_Write(ISDS_CTRL1_XL, 0x54);
	ISDS_Write(ISDS_CTRL2_G, 0x5C);

	// Enable block data update
	// Enable automatic address increment
	ISDS_Write(ISDS_CTRL3_C, 0x04);

//	// Select bandwidth: ODR/2 Hz
//	// Select full scale: +/- 16 g, +/- 2000 dps
//	I2C_buffer[0] = ISDS_CTRL1_XL;
//	I2C_buffer[1] = 0x;
//	HAL_I2C_Master_Transmit(&hi2c1, ISDS_DEVICE_ADDRESS, I2C_buffer, 2, ISDS_I2C_TIMEOUT);
//
//	I2C_buffer[0] = ISDS_CTRL8_XL;
//	I2C_buffer[1] = 0x;
//	HAL_I2C_Master_Transmit(&hi2c1, ISDS_DEVICE_ADDRESS, I2C_buffer, 2, ISDS_I2C_TIMEOUT);
//
//	I2C_buffer[0] = ISDS_CTRL6_C;
//	I2C_buffer[1] = 0x;
//	HAL_I2C_Master_Transmit(&hi2c1, ISDS_DEVICE_ADDRESS, I2C_buffer, 2, ISDS_I2C_TIMEOUT);
//
//	I2C_buffer[0] = ISDS_CTRL2_G;
//	I2C_buffer[1] = 0x;
//	HAL_I2C_Master_Transmit(&hi2c1, ISDS_DEVICE_ADDRESS, I2C_buffer, 2, ISDS_I2C_TIMEOUT);

	// Read XLDA and GDA bit in status register
	I2C_buffer[0] = ISDS_STATUS_REG;

	HAL_I2C_Master_Transmit(&ISDS_I2C_HANDLE, ISDS_DEVICE_ADDRESS, I2C_buffer, 1, ISDS_I2C_TIMEOUT);
	HAL_I2C_Master_Receive (&ISDS_I2C_HANDLE, ISDS_DEVICE_ADDRESS, I2C_buffer, 1, ISDS_I2C_TIMEOUT);

	// If XLDA and GDA == 0, no data

	// Else

	// Request data from output register G_X_OUT_L, etc

	// Concatenate bytes into 16bit var

	// Multiply by sensitivity

	// Output in g and dps

	// repeat
}

int16_t	ISDS_GetTemperature(void)
{
	uint8_t I2C_buffer[2];
	int16_t temperature = 0;

	ISDS_Read(ISDS_T_OUT_L, 2, I2C_buffer);

	temperature = (int16_t) ( (I2C_buffer[1] << 8)  + I2C_buffer[0] );
	temperature = (int16_t) ((((float) temperature) / 2.56f) + 2500.0f);

	return temperature;
}

void 	ISDS_GetData(ISDS_data_t * measurements)
{
	uint8_t I2C_buffer[14];

	ISDS_Read(ISDS_T_OUT_L, 14, I2C_buffer);

	measurements->temperature = (int16_t) ((I2C_buffer[1] << 8) | I2C_buffer[0]);
	measurements->temperature = (int16_t) ((((float) measurements->temperature) / 2.56f) + 2500.0f);			// °C/100

	measurements->angular_rate[ISDS_X_AXIS] = (int16_t) ((I2C_buffer[ 3] << 8) | I2C_buffer[ 2]) *  70 / 1000;	// mdps
	measurements->angular_rate[ISDS_Y_AXIS] = (int16_t) ((I2C_buffer[ 5] << 8) | I2C_buffer[ 4]) *  70 / 1000;	// mdps
	measurements->angular_rate[ISDS_Z_AXIS] = (int16_t) ((I2C_buffer[ 7] << 8) | I2C_buffer[ 6]) *  70 / 1000;	// mdps

	measurements->acceleration[ISDS_X_AXIS] = (int16_t) ((I2C_buffer[ 9] << 8) | I2C_buffer[ 8]) * 488 / 1000;	// mg
	measurements->acceleration[ISDS_Y_AXIS] = (int16_t) ((I2C_buffer[11] << 8) | I2C_buffer[10]) * 488 / 1000;	// mg
	measurements->acceleration[ISDS_Z_AXIS] = (int16_t) ((I2C_buffer[13] << 8) | I2C_buffer[12]) * 488 / 1000;	// mg
}
