MechatronixLab/WPM/SOFTWARE/WPM_WL55/WPM_WL55/App/Inc/version.h

/*
 * version.h
 *
 *  Created on: Feb 3, 2024
 *      Author: Eng. André A. M. Araújo
 */

#ifndef INC_VERSION_H_
#define INC_VERSION_H_

#define V_MAJOR		1
#define	V_MINOR		0
#define V_PATCH		0

#define V_YEAR	 2024
#define V_MONTH    02
#define V_DAY      25

#endif /* INC_VERSION_H_ */
