MechatronixLab/WPM/SOFTWARE/WPM_WL55/WPM_WL55/App/Inc/buzzer.h

/*
 * buzzer.h
 *
 *  Created on: Feb 18, 2024
 *      Author: Eng. André A. M. Araújo
 */

#ifndef INC_BUZZER_H_
#define INC_BUZZER_H_

#include "main.h"
#include "tim.h"

#define BUZZER_TIMER_HANDLE	htim1
#define BUZZER_PWM_CHANNEL	TIM_CHANNEL_1

void BUZZER_On(void);
void BUZZER_Off(void);
void BUZZER_SetVolume(uint8_t volume);
//void BUZZER_SetTone(uint16_t frequency);	// TODO

#endif /* INC_BUZZER_H_ */
