MechatronixLab/WPM/SOFTWARE/WPM_WL55/WPM_WL55/App/Inc/console.h

/*
 * console.h
 *
 *  Created on: Feb 10, 2024
 *      Author: Eng. André A. M. Araújo
 */

#ifndef INC_CONSOLE_H_
#define INC_CONSOLE_H_

#include <stdio.h>

#include "cli.h"
#include "version.h"

void CONSOLE_Init(void);

#endif /* INC_CONSOLE_H_ */
