MechatronixLab/WPM/SOFTWARE/WPM_WL55/WPM_WL55/App/Inc/average.h

/*
 * average.h
 *
 *  Created on: Feb 9, 2024
 *      Author: Eng. André A. M. Araújo
 */

#ifndef INC_AVERAGE_H_
#define INC_AVERAGE_H_

#include "main.h"

#define MOVING_AVERAGE_PERIOD	10



#endif /* INC_AVERAGE_H_ */
