MechatronixLab/WPM/SOFTWARE/WPM_WL55/WPM_WL55/App/Src/cli.c

/*
 * cli.c
 *
 *  Created on: Feb 1, 2024
 *      Author: Eng. André A. M. Araújo
 */

#include "cli.h"

void CLI_Write(char * buffer)
{
	HAL_UART_Transmit(&CLI_UART_HANDLE,
			(uint8_t *)buffer, strlen(buffer), HAL_MAX_DELAY);
}

void CLI_NewLine(void)
{
	CLI_Write("\r\n");
}
