MechatronixLab/WPM/SOFTWARE/WPM_C011/WPM_C011/Core/Inc/console.h

/*
 * console.h
 *
 *  Created on: Nov 11, 2023
 *      Author: André A. M. Araújo
 */

#ifndef INC_CONSOLE_H_
#define INC_CONSOLE_H_

#include <string.h>

#include "usart.h"

void CONSOLE_tx(char * string);

#endif /* INC_CONSOLE_H_ */
