MechatronixLab/WPM/(commit log)

2023-11-11 Added basic I2C functionality and started MAX30102 library.
2023-11-15 Added proximity detection and reset functions to MAX30102.
    [app.c, app.h, max30102.c, max30102.h]
2023-11-17 Fixed DrawLineH counter (int8 always < 128).
    [app.c]
2023-11-17 Added vertical line function but also not working. Added ADC for internal Vref and temperature.
    [WPM_C011.ioc, adconverter.c, adconverter.h, app.c, oled_ssd1306.h]
2023-11-24 Added regiter map for the IMU. Replaced font of OLED display.
    [max30102.h, wsen-isds.c, wsen-isds.h]
2023-11-25 Included temperature and angular rate readings (still needs adjustments).
2023-11-28 Added acceleration readings. Added sensitivity conversion for angular rate and acceleration; temperature in the works.
2023-11-28 Testing temperature readings, conversions and serial data stream.
2023-12-05 Fixed Horizontal and Vertical Line functions. Added diagonal line function. Updated DrawLine to use functions mentioned before.
    [app.c, graphics.c, graphics.h]
2023-12-30 Starting testing with STM32WL55 Nucleo board.
2023-12-31 Testing some other examples but still no clue on how to connect the STM32 to the E32 module from EBYTE.
2024-01-13 Managed to get *some* communication from STM32WL55 to E32 module using SubGHz Ping-Pong example.
2024-02-02 Added I2C functionality and teste using OLED and Graphics libs from STM32C011 project.
2024-02-03 Inclusion of WSEN-ISDS IMU library; Inverted Logo and added instructions for image array generation.
    [graphics.c, wsen-isds.c, wsen-isds.h]
2024-02-03 Added TIM16 for periodic interrupt. Created isr.c/.h to handle interrupts. Linked newly added libs to app.c.
2024-02-04 General refactoring of I2C libs. Symbolic definition of TIM16_PSC and TIM16_ARR.
2024-02-06 Added draft of project description; added RED and IR readings to serial out; bypassed LoRa serial messages; fixed RED and IR 18-bit data calculation.
    [app.c, lora.c, max30102.c, max30102.h, wsen-isds.h]
2024-02-06 Found a good configuration for the LEDs and sensor gains for reading to be stable.
2024-02-06 Set LED currents to 10mA.
2024-02-10 Got data via serial port an analysed to calculate SpO2. Not sure calculations are right because SpO2 result is a bit low (< 90%).
    [spo2.csv]
2024-02-10 Tryied AC calculation based on Excel spreadsheet but there is an error in the result. Meanwhile, found a library from Maxim - trying to integrate it.
    [app.c, app.h, average.h]
2024-02-10 Changed sampling period to 50Hz.
2024-02-10 Moved LED init sweep to display.c
2024-02-11 Updated screens image file and ASCII Art code generation Excel spreadsheet. Added IMU.c/.h to clean up ISDS commands.
    [ASCII ART CODE TO CLI.xlsx]
2024-02-17 Starting work on pleth curve. Changed I2C to 1Mbps.
2024-02-17 Added buttons interrupt functionality. It seems debounce is not needed - the hardware has debouncing circuit.
2024-02-18 Added basic functionality for the buzzer.
    [WPM_WL55.ioc, app.c, app.h, buzzer.c, buzzer.h, main.h]
2024-02-19 Made a new Excel sheet to calculate SpO2 and Pulse. Got samples from 2 people.
    [spo2.csv, spo2_andre_ana.xlsx]
2024-02-24 Added SpO2 manual calculation. Still reading incorrect but now it seems compatible with the Excel sheet.
    [spo2_andre_ana.xlsx]
2024-02-24 Added pulse calculaton algorithm. Changed UART baud rate to 921600. Still needs a lot of refactoring.
    [spo2_andre_ana.xlsx]
2024-02-24 Fixed truncation error on 'ratio'.
    [auxiliary.c, oximetry.c]
2024-02-24 Fixed truncation error on 'ratio' calculation and changed calculation to integer numbers.
    [app.c, oximetry.c]
2024-02-25 Found a werid bug where the program hard faults but only if debugging. Will need to check it later and continue without debugging for now.
    [app.c, buzzer.c, buzzer.h, isr.h, max30102.c, max30102.h, oximetry.c, oximetry.h]
2024-02-25 Fixed MAX30102 temperature conversion. Tuned heart beat detection, but needs further improvement.
    [app.c, buzzer.h, isr.h, max30102.c, max30102.h, oximetry.c, oximetry.h, version.h]
2024-02-25 Fixed a bug on printing IMU data due to the legend 'm/s2' contianing a number.
    [app.c, graphics.c, graphics.h, wsen-isds.c]
2024-02-25 Adjustment to IMU setup (reverted to 208 Hz).
    [app.c, wsen-isds.c]
2024-02-25 Added images of the prototype.
