MechatronixLab/WPM/(notices)

Notices in the files:
SOFTWARE/WPM_WL55/WPM_WL55/Drivers/Radio/radio_conf.h:
Copyright (c) 2021 STMicroelectronics.
All rights reserved.
This software is licensed under terms that can be found in the LICENSE file
SOFTWARE/WPM_WL55/WPM_WL55/Core/Inc/main.h:
Copyright (c) 2024 STMicroelectronics.
